heolfief/minimood/Hardware/PCB/main_board/3dmodels/RK09L12-L15H.STEP

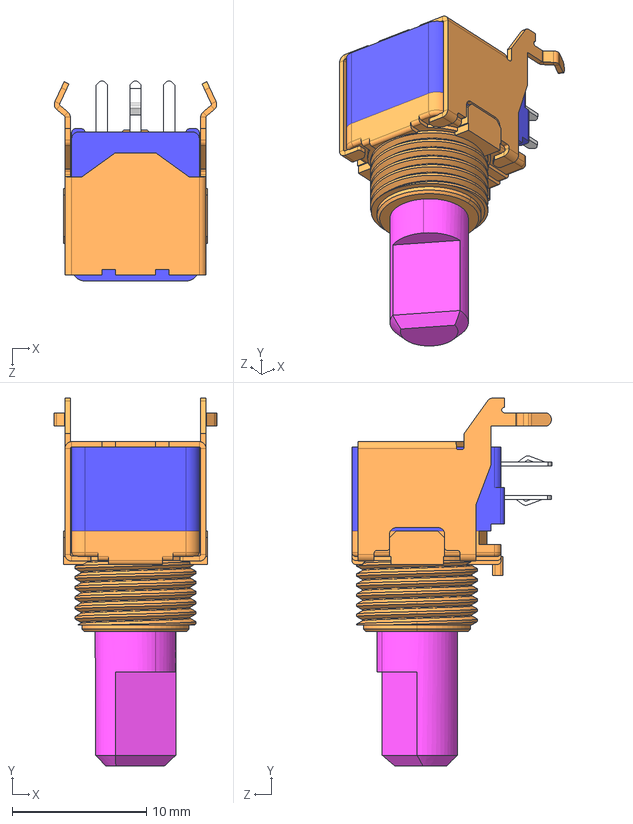
[picture p1: CAD file, 2020-09-23]
Hardware/PCB/main_board/3dmodels/RK09L12-L15H.STEP
12.1 x 27.4 x 14.9 mm
