heolfief/minimood/Hardware/PCB/main_board/3dmodels/096_oled_display.STEP

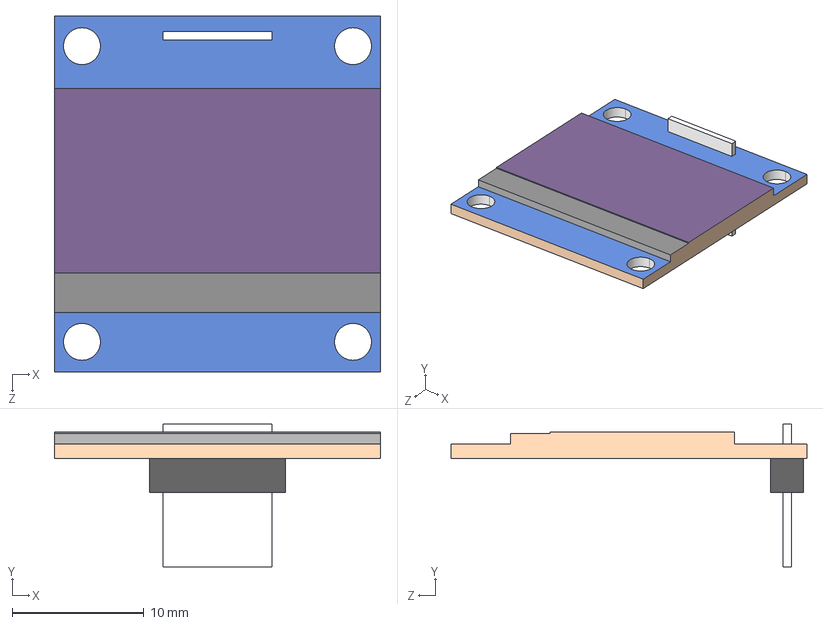
[picture p2: CAD file, 2020-03-08]
Hardware/PCB/main_board/3dmodels/096_oled_display.STEP
24.8 x 10.8 x 27.0 mm
