heolfief/minimood/Hardware/PCB/main_board/3dmodels/USB_Type_A_Socket.step

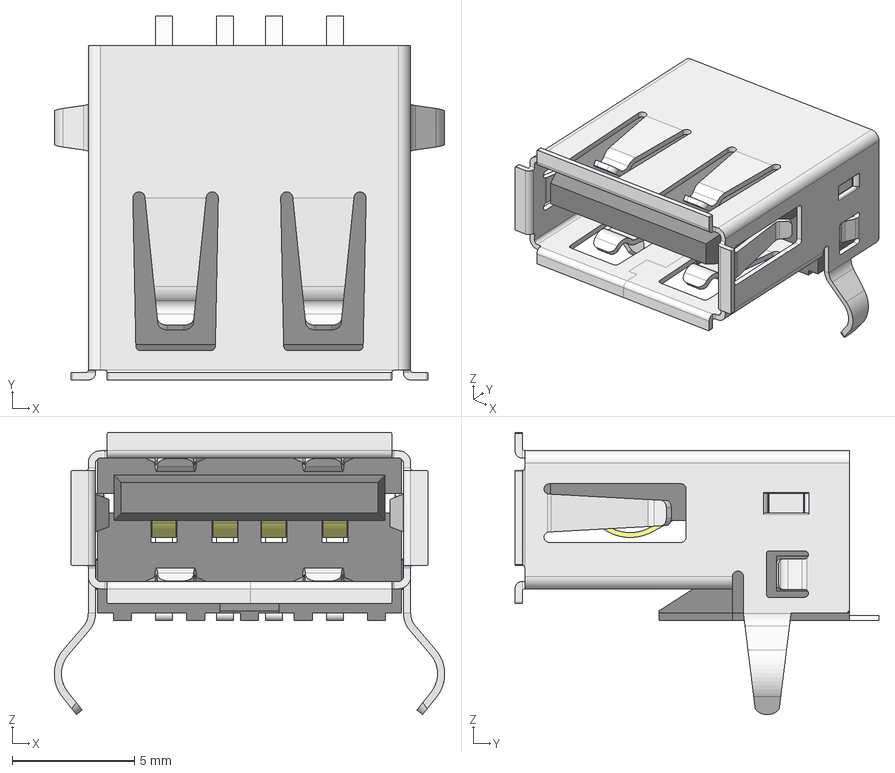
[picture p3: CAD file, 2020-02-25]
Hardware/PCB/main_board/3dmodels/USB_Type_A_Socket.step
16.0 x 14.9 x 11.5 mm
