heolfief/minimood/Hardware/PCB/main_board/3dmodels/USB 2.0 Type B Connector Right Angle (Würth 61400416121).stp

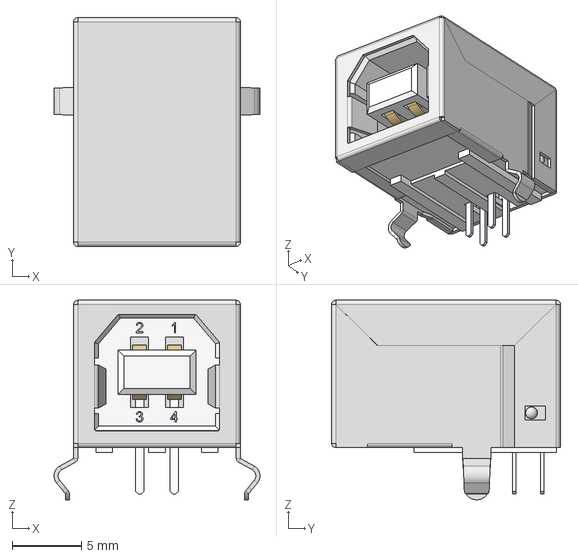
[picture p4: CAD file, 2020-02-25]
Hardware/PCB/main_board/3dmodels/USB 2.0 Type B Connector Right Angle (Würth 61400416121).stp
14.8 x 16.5 x 14.4 mm
