heolfief/minimood/Hardware/PCB/main_board/3dmodels/plastec_jack.stp

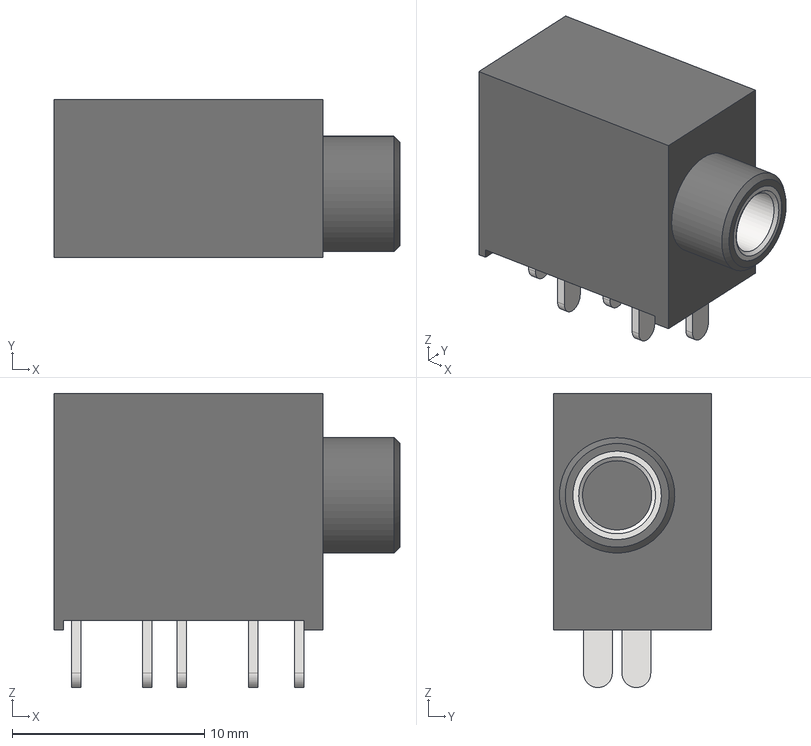
[picture p5: CAD file, 2020-02-25]
Hardware/PCB/main_board/3dmodels/plastec_jack.stp
18.0 x 8.20 x 15.3 mm
