heolfief/minimood/Hardware/Spice_sim_orcad/VCF_Orcad_simulation/VCF-PSpiceFiles/SCHEMATIC1/test/test.cir

** Profile: "SCHEMATIC1-test"  [ C:\Users\Julien\Documents\INSA EII\Semestre 8\ProjetPluri\minimood\Hardware\VCF_Orcad_simulation\vcf-pspicefiles\schematic1\test.sim ] 

** Creating circuit file "test.cir" 
** WARNING: THIS AUTOMATICALLY GENERATED FILE MAY BE OVERWRITTEN BY SUBSEQUENT SIMULATIONS

*Libraries: 
* Profile Libraries :
* Local Libraries :
* From [PSPICE NETLIST] section of C:\Users\Julien\AppData\Roaming\SPB_Data\cdssetup\OrCAD_PSpice\17.4.0\PSpice.ini file:
.lib "nom.lib" 

*Analysis directives: 
.TRAN  0 10m 0 1u 
.OPTIONS ADVCONV
.PROBE64 V(alias(*)) I(alias(*)) W(alias(*)) D(alias(*)) NOISE(alias(*)) 
.INC "..\SCHEMATIC1.net" 


.END
