heolfief/minimood/(list of files, drawings)

Other design files:
Hardware/Spice_sim_orcad/Distortion_Orcad_simulation/DISTORTION_ORCAD_SIMULATION.DSN
Hardware/Spice_sim_orcad/Distortion_Orcad_simulation/Distortion_Orcad_simulation.opj
Hardware/Spice_sim_orcad/VCF_Orcad_simulation/VCF.DSN
Hardware/Spice_sim_orcad/VCF_Orcad_simulation/VCF.opj
