heolfief/minimood/Hardware/PCB/main_board/main_board.kicad_pcb

## KiCad design Hardware/PCB/main_board/main_board.kicad_pcb (2020-09-23)

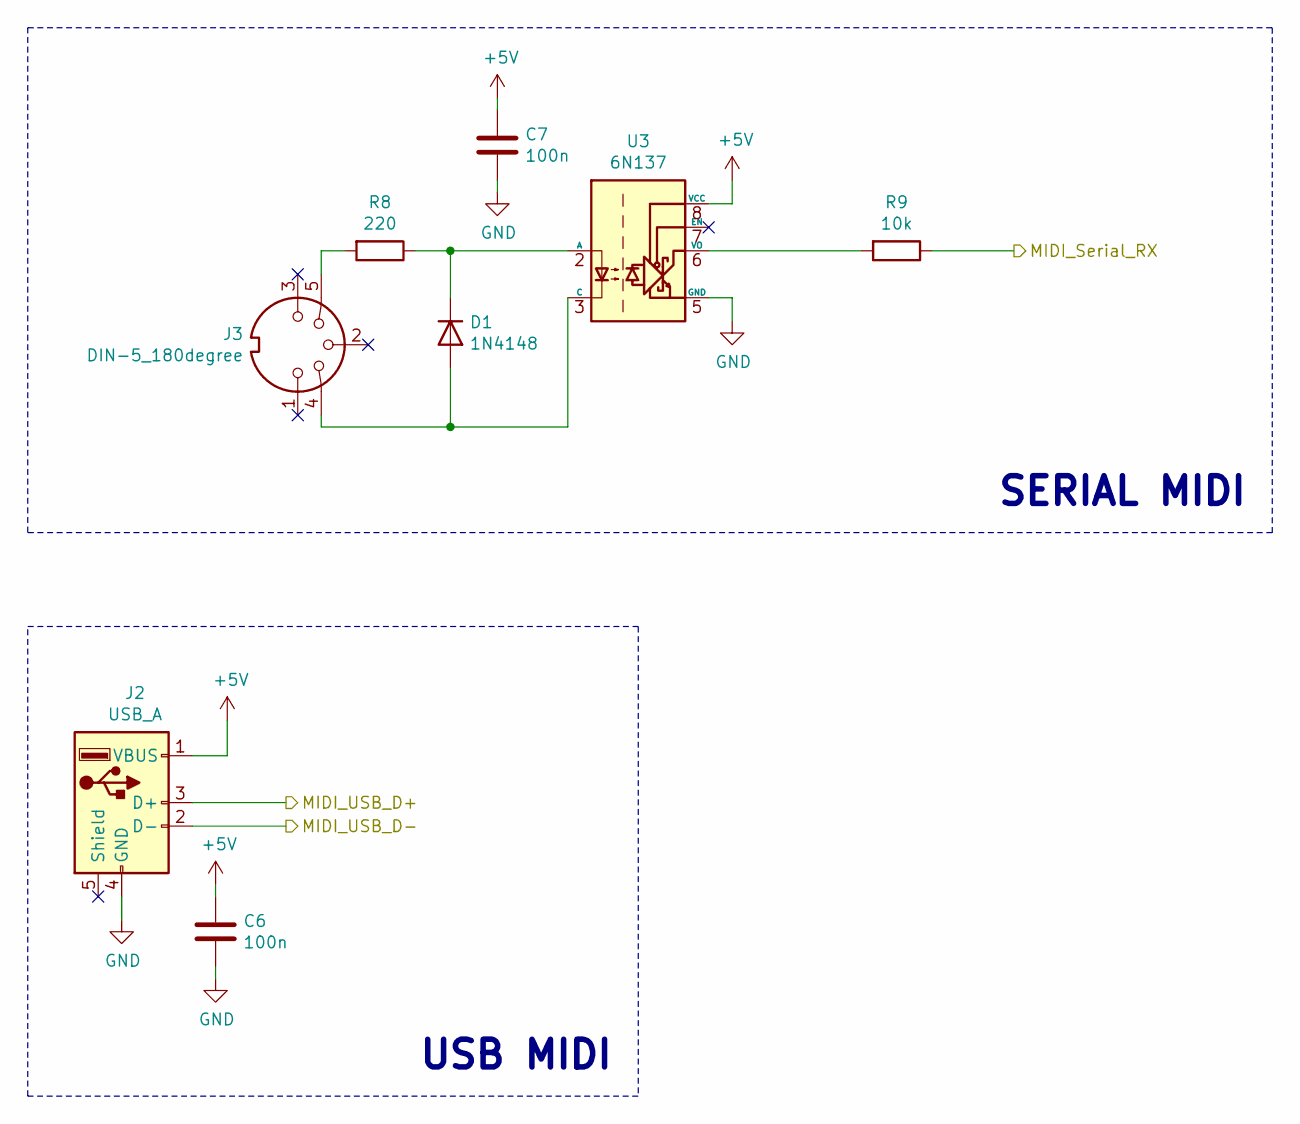
[picture p6: schematic MIDI.sch, MiniMood]

Parts:
C6, C7: 100n; C_0805_2012Metric
D1: 1N4148; D_SOD-123
J2: USB_A; USB_A_Stewart_SS-52100-001_Horizontal
J3: DIN-5_180degree; MIDI_DIN5
R8: 220; R_0805_2012Metric
R9: 10k; R_0805_2012Metric
U3: 6N137; SOIC-8_3.9x4.9mm_P1.27mm

Connections:
+5V: C6.1, C7.1, J2.1 (VBUS), U3.8 (VCC); also elsewhere on the board
/MIDI/MIDI_Serial_RX: R9.1; also elsewhere on the board
/MIDI/MIDI_USB_D+: J2.3 (D+); also elsewhere on the board
/MIDI/MIDI_USB_D-: J2.2 (D-); also elsewhere on the board
GND: C6.2, C7.2, J2.4 (GND), U3.5 (GND); also elsewhere on the board
unnamed: D1.1 (K), R8.1, U3.2 (A)
unnamed: D1.2 (A), J3.4, U3.3 (C)
unnamed: J3.5, R8.2
unnamed: R9.2, U3.6 (VO)

Notes on the sheet:
SERIAL MIDI
USB MIDI

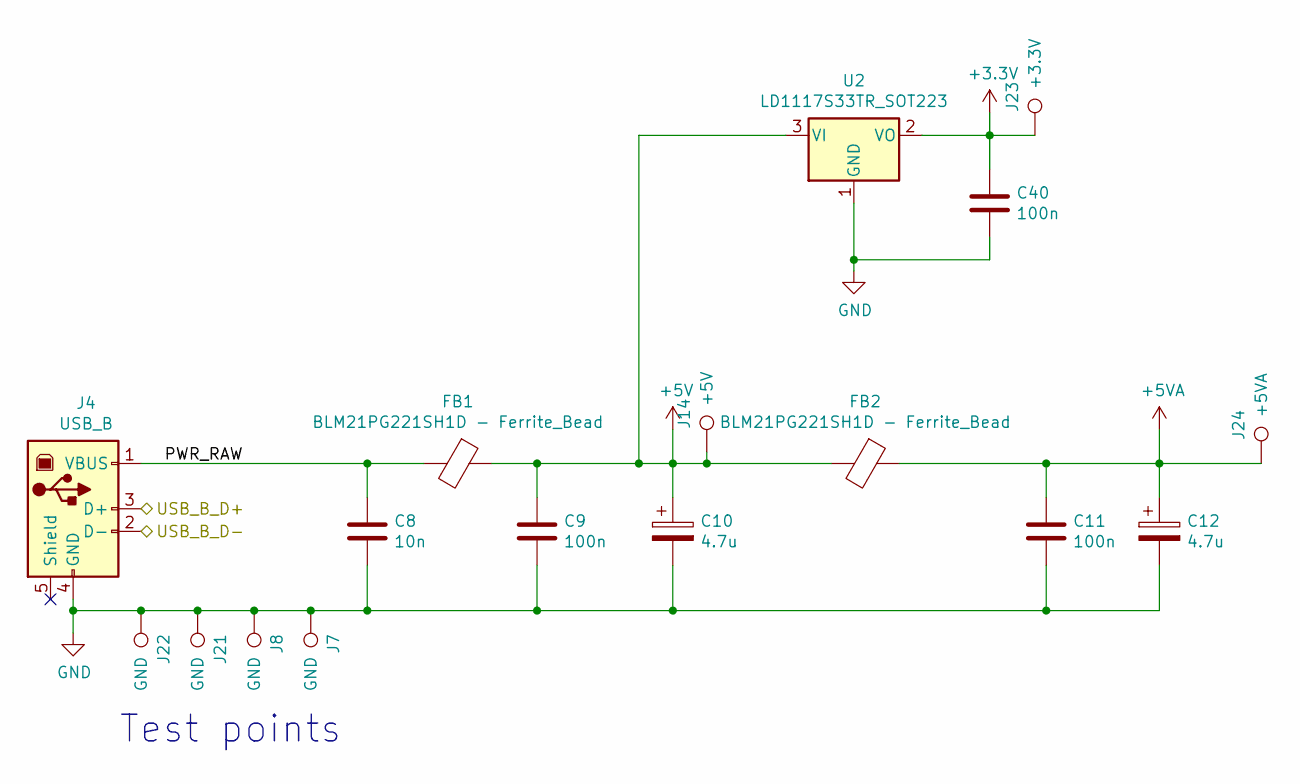
[picture p7: schematic power.sch, MiniMood]

Parts:
C8: 10n; C_0805_2012Metric
C9, C11, C40: 100n; C_0805_2012Metric
C10, C12: 4.7u; CP_Elec_4x5.4
FB1, FB2: BLM21PG221SH1D - Ferrite_Bead; L_0805_2012Metric
J4: USB_B; USB_B_OST_USB-B1HSxx_Horizontal
J7, J8, J21, J22: GND; TestPoint_THTPad_D1.0mm_Drill0.5mm
J14: +5V; TestPoint_THTPad_D1.0mm_Drill0.5mm
J23: +3.3V; TestPoint_THTPad_D1.0mm_Drill0.5mm
J24: +5VA; TestPoint_THTPad_D1.0mm_Drill0.5mm
U2: LD1117S33TR_SOT223; SOT-223-3_TabPin2

Connections:
+3V3: C40.1, J23.1, U2.2 (VO); also elsewhere on the board
+5V: C9.1, C10.1, FB1.1, FB2.2, J14.1, U2.3 (VI); also elsewhere on the board
+5VA: C11.1, C12.1, FB2.1, J24.1; also elsewhere on the board
/power/PWR_RAW: C8.1, FB1.2, J4.1 (VBUS)
/power/USB_B_D+: J4.3 (D+); also elsewhere on the board
/power/USB_B_D-: J4.2 (D-); also elsewhere on the board
GND: C8.2, C9.2, C10.2, C11.2, C12.2, C40.2, J4.4 (GND), J7.1, J8.1, J21.1, J22.1, U2.1 (GND); also elsewhere on the board

Notes on the sheet:
Test points

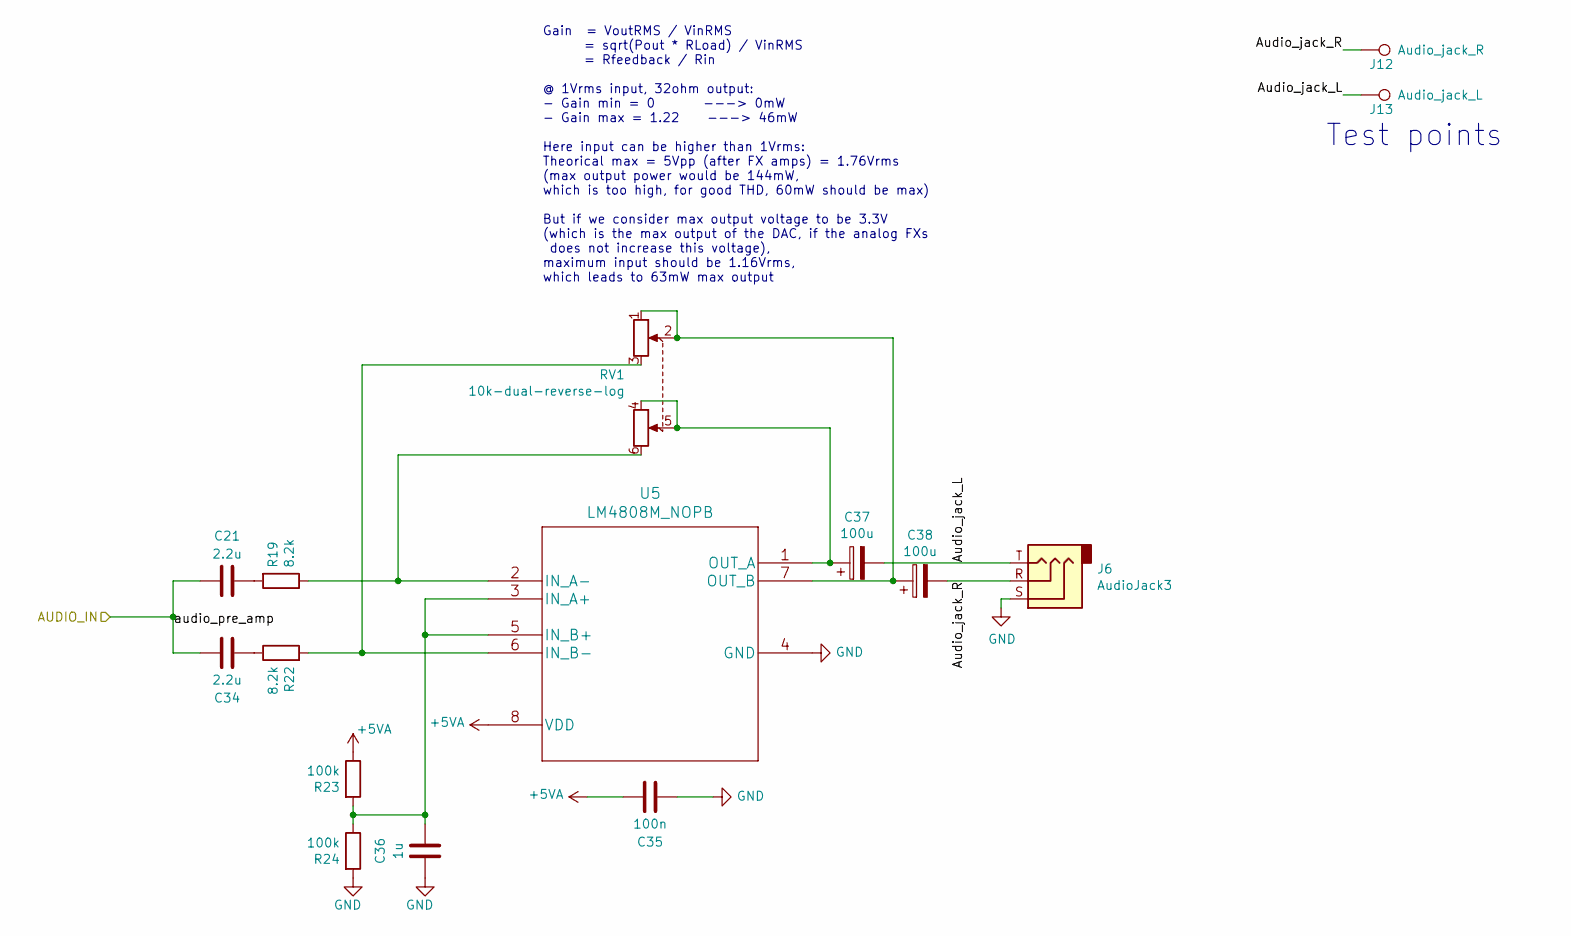
[picture p8: schematic audio_out.sch, MiniMood]

Parts:
C21, C34: 2.2u; C_0805_2012Metric
C35: 100n; C_0805_2012Metric
C36: 1u; C_0805_2012Metric
C37, C38: 100u; CP_Elec_6.3x5.4
J6: AudioJack3; audio_jack_3.5mm_KYCON_STX-3000
J12: Audio_jack_R; TestPoint_THTPad_D1.0mm_Drill0.5mm
J13: Audio_jack_L; TestPoint_THTPad_D1.0mm_Drill0.5mm
R19, R22: 8.2k; R_0805_2012Metric
R23, R24: 100k; R_0805_2012Metric
RV1: 10k-dual-reverse-log; Potentiometer_Alps_RK09L_Double_Horizontal
U5: LM4808M_NOPB; LM4808M&slash_NOPB

Connections:
+5VA: C35.2, R23.1, U5.8 (VDD); also elsewhere on the board
/audio_out/AUDIO_IN: C21.1, C34.2; also elsewhere on the board
/audio_out/Audio_jack_L: C37.2, J6.T, J13.1
/audio_out/Audio_jack_R: C38.2, J6.R, J12.1
GND: C35.1, C36.1, J6.S, R24.2, U5.4 (GND); also elsewhere on the board
unnamed: C21.2, R19.2
unnamed: C34.1, R22.1
unnamed: C36.2, R23.2, R24.1, U5.3 (IN_A+), U5.5 (IN_B+)
unnamed: C37.1, RV1.4, RV1.5, U5.1 (OUT_A)
unnamed: C38.1, RV1.1, RV1.2, U5.7 (OUT_B)
unnamed: R19.1, RV1.6, U5.2 (IN_A-)
unnamed: R22.2, RV1.3, U5.6 (IN_B-)

Notes on the sheet:
Test points
Gain = VoutRMS / VinRMS = sqrt(Pout * RLoad) / VinRMS = Rfeedback / Rin @ 1Vrms input, 32ohm output: - Gain min = 0 ---> 0mW - Gain max = 1.22 ---> 46mW Here input can be higher than 1Vrms: Theorical max = 5Vpp (after FX amps) = 1.76Vrms (max output power would be 144mW, which is too high, for good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

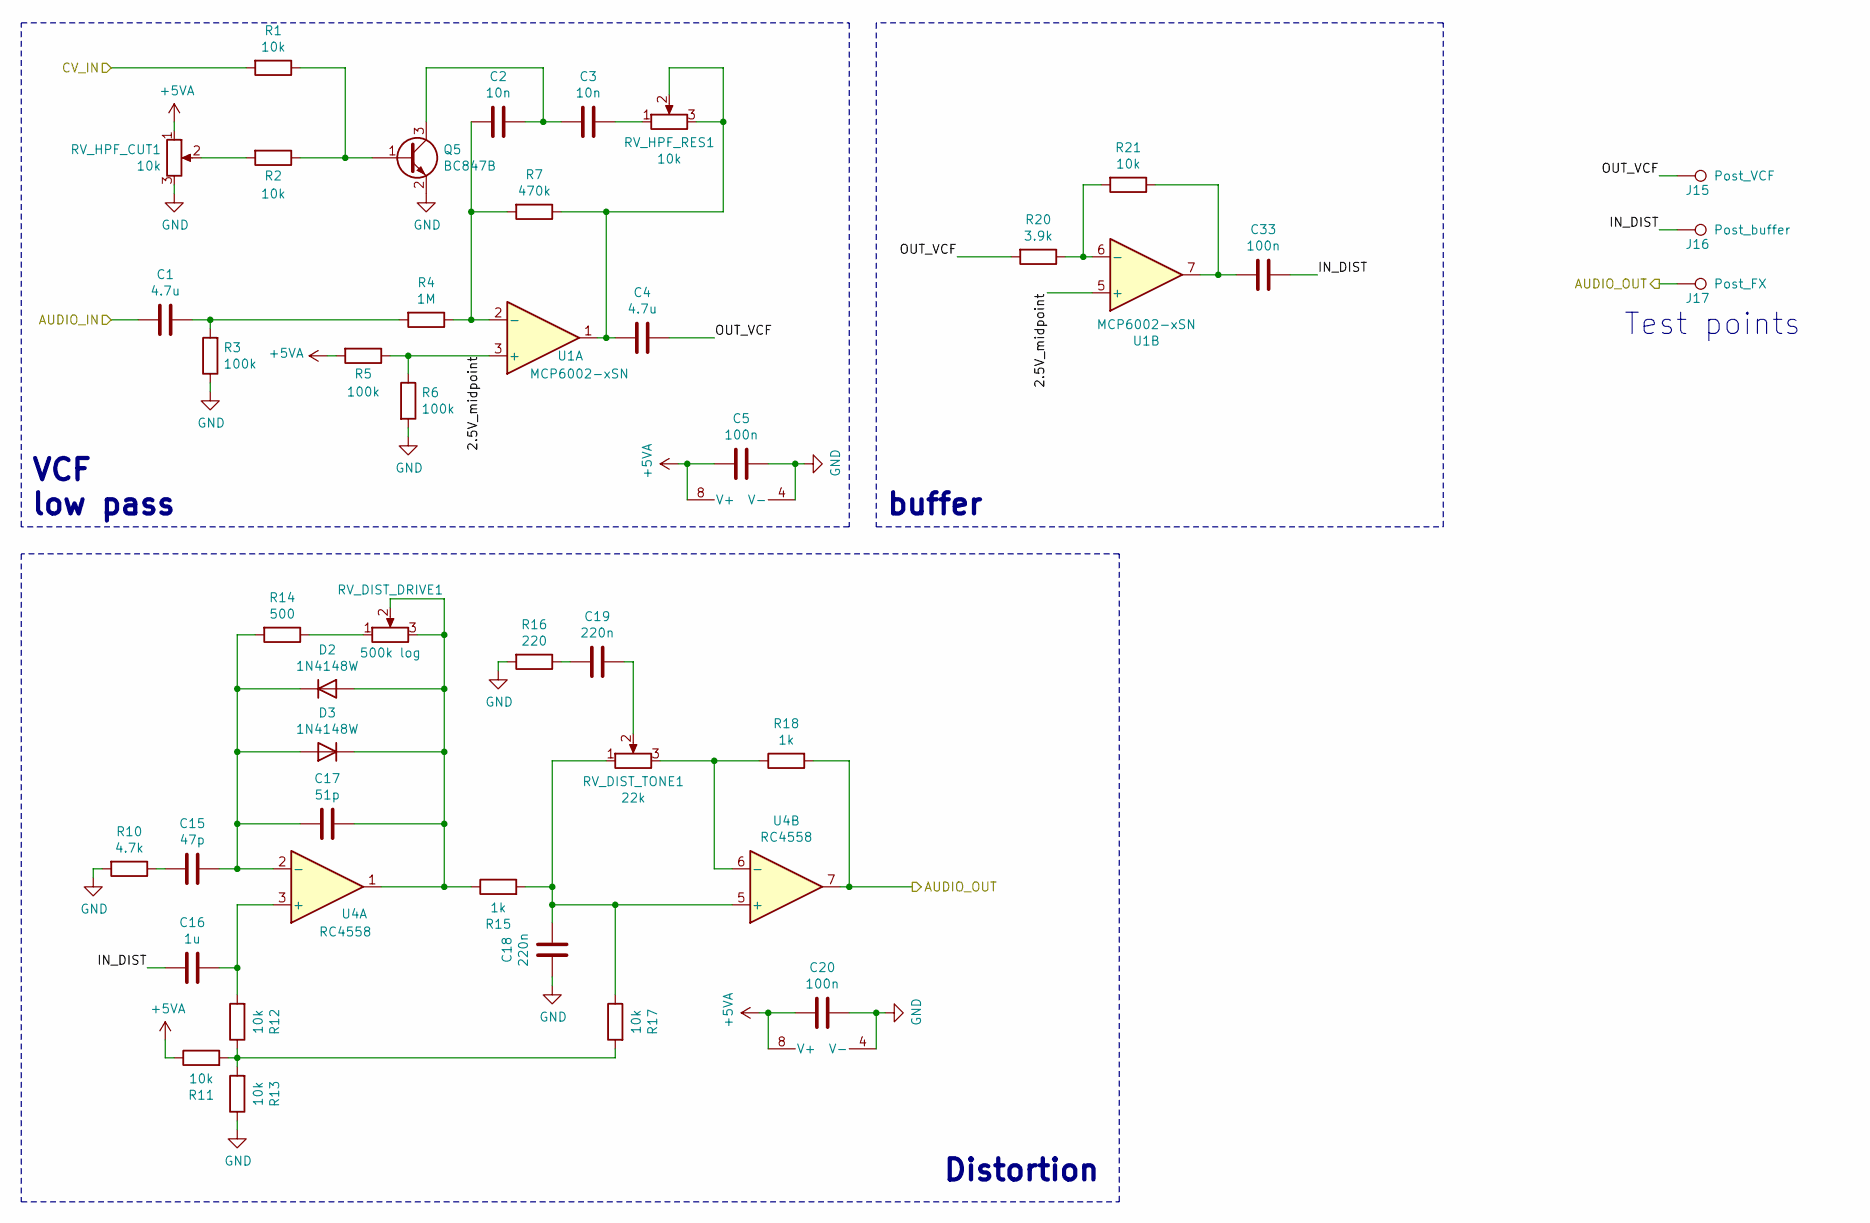
[picture p9: schematic analogFX.sch, MiniMood]

Parts:
C1, C4: 4.7u; C_0805_2012Metric
C2, C3: 10n; C_0805_2012Metric
C5, C20, C33: 100n; C_0805_2012Metric
C15: 47p; C_0805_2012Metric
C16: 1u; C_0805_2012Metric
C17: 51p; C_0805_2012Metric
C18, C19: 220n; C_0805_2012Metric
D2, D3: 1N4148W; D_SOD-123
J15: Post_VCF; TestPoint_THTPad_D1.0mm_Drill0.5mm
J16: Post_buffer; TestPoint_THTPad_D1.0mm_Drill0.5mm
J17: Post_FX; TestPoint_THTPad_D1.0mm_Drill0.5mm
Q5: BC847B; SOT-23
R1, R2, R11, R12, R13, R17, R21: 10k; R_0805_2012Metric
R3, R5, R6: 100k; R_0805_2012Metric
R4: 1M; R_0805_2012Metric
R7: 470k; R_0805_2012Metric
R10: 4.7k; R_0805_2012Metric
R14: 500; R_0805_2012Metric
R15, R18: 1k; R_0805_2012Metric
R16: 220; R_0805_2012Metric
R20: 3.9k; R_0805_2012Metric
RV_DIST_DRIVE1: 500k log; Potentiometer_Alps_RK09K_Single_Vertical
RV_DIST_TONE1: 22k; Potentiometer_Alps_RK09K_Single_Vertical
RV_HPF_CUT1: 10k; Potentiometer_Alps_RK09K_Single_Vertical
RV_HPF_RES1: 10k; Potentiometer_Alps_RK09K_Single_Vertical
U1: MCP6002-xSN; SOIC-8_3.9x4.9mm_P1.27mm
U4: RC4558; SOIC-8_3.9x4.9mm_P1.27mm

Connections:
+5VA: C5.2, C20.2, R5.2, R11.1, RV_HPF_CUT1.1, U1.8 (V+), U4.8 (V+); also elsewhere on the board
/analogFX/2.5V_midpoint: R5.1, R6.1, U1.3 (+), U1.5 (+)
/analogFX/AUDIO_IN: C1.2; also elsewhere on the board
/analogFX/CV_IN: R1.2; also elsewhere on the board
/analogFX/IN_DIST: C16.2, C33.1, J16.1
/analogFX/OUT_VCF: C4.1, J15.1, R20.2
/audio_out/AUDIO_IN: J17.1, R18.2, U4.7; also elsewhere on the board
GND: C5.1, C18.2, C20.1, Q5.2 (E), R3.1, R6.2, R10.2, R13.1, R16.2, RV_HPF_CUT1.3, U1.4 (V-), U4.4 (V-); also elsewhere on the board
unnamed: C1.1, R3.2, R4.2
unnamed: C2.1, C3.2, Q5.3 (C)
unnamed: C2.2, R4.1, R7.2, U1.2 (-)
unnamed: C3.1, RV_HPF_RES1.1
unnamed: C4.2, R7.1, RV_HPF_RES1.2, RV_HPF_RES1.3, U1.1
unnamed: C15.1, C17.2, D2.1 (K), D3.2 (A), R14.2, U4.2 (-)
unnamed: C15.2, R10.1
unnamed: C16.1, R12.2, U4.3 (+)
unnamed: C17.1, D2.2 (A), D3.1 (K), R15.1, RV_DIST_DRIVE1.2, RV_DIST_DRIVE1.3, U4.1
unnamed: C18.1, R15.2, R17.1, RV_DIST_TONE1.1, U4.5 (+)
unnamed: C19.1, RV_DIST_TONE1.2
unnamed: C19.2, R16.1
unnamed: C33.2, R21.1, U1.7
unnamed: Q5.1 (B), R1.1, R2.1
unnamed: R2.2, RV_HPF_CUT1.2
unnamed: R11.2, R12.1, R13.2, R17.2
unnamed: R14.1, RV_DIST_DRIVE1.1
unnamed: R18.1, RV_DIST_TONE1.3, U4.6 (-)
unnamed: R20.1, R21.2, U1.6 (-)

Notes on the sheet:
VCF low pass
Distortion
buffer
Test points

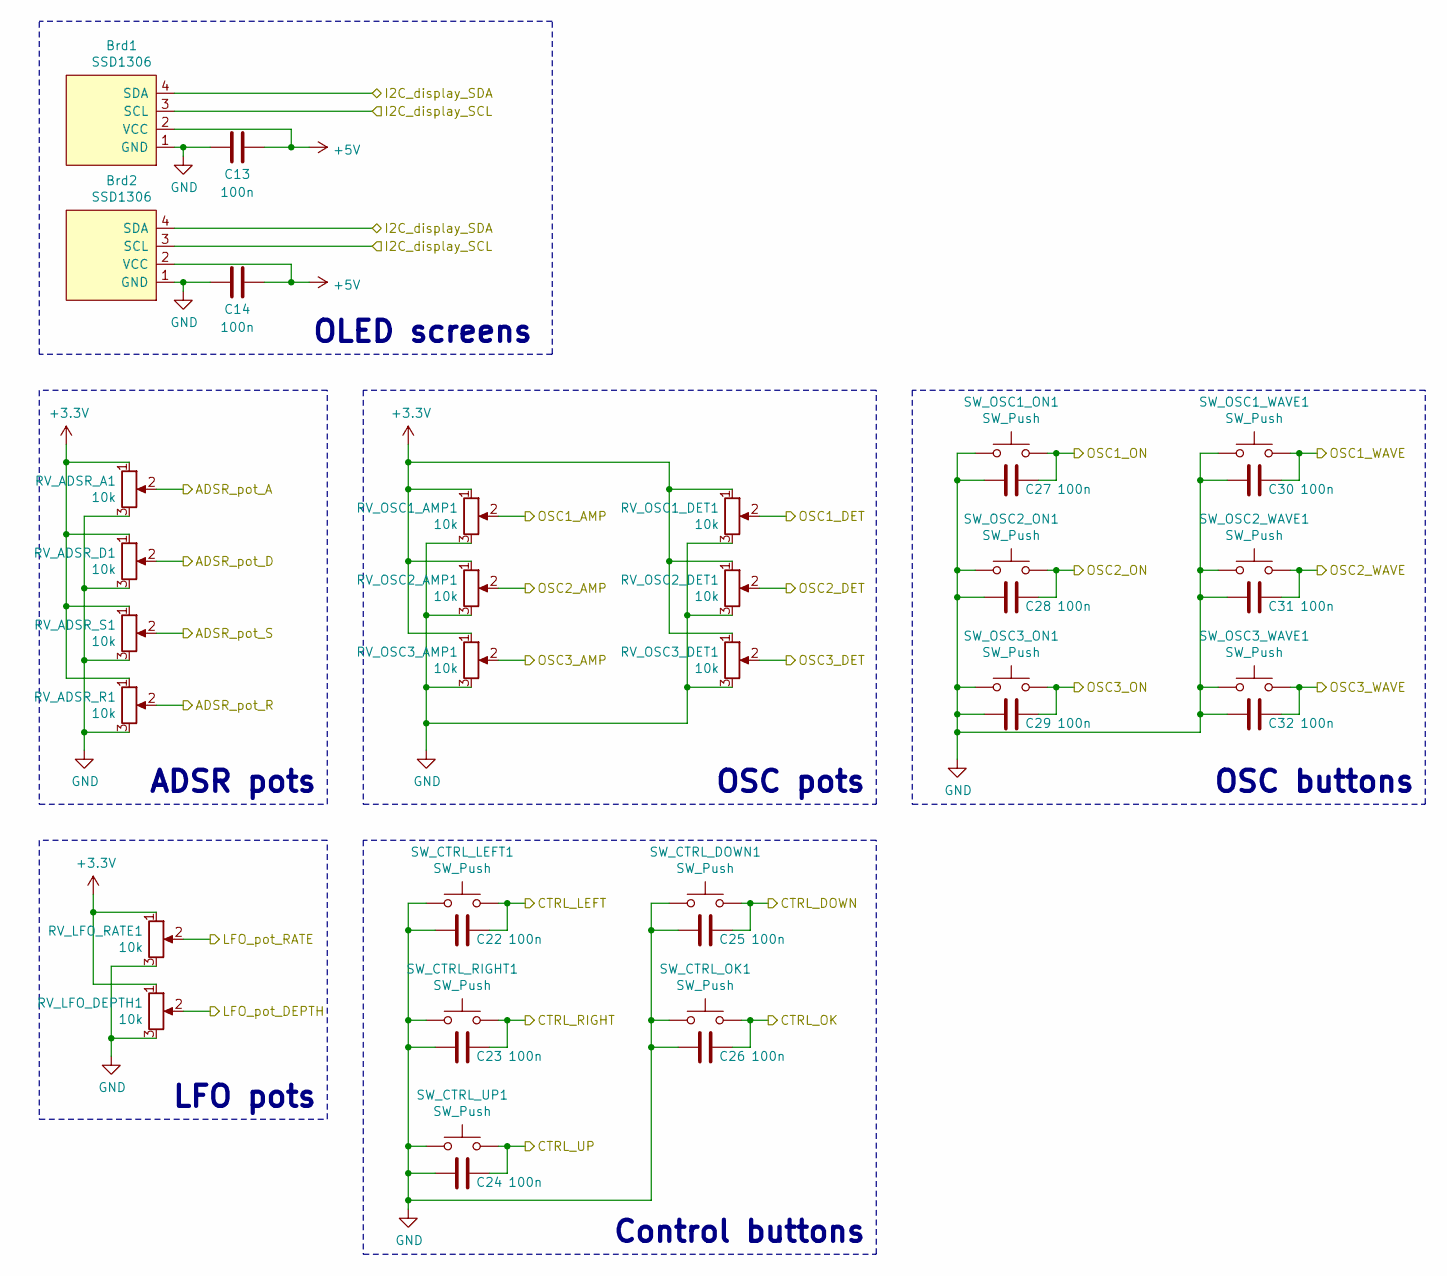
[picture p10: schematic HMI.sch, MiniMood]

Parts:
Brd1, Brd2: SSD1306; 128x64OLED
C13, C14, C22, C23, C24, C25, C26, C27, C28, C29, C30, C31, C32: 100n; C_0805_2012Metric
RV_ADSR_A1: 10k; Potentiometer_Alps_RK09K_Single_Vertical
RV_ADSR_D1: 10k; Potentiometer_Alps_RK09K_Single_Vertical
RV_ADSR_R1: 10k; Potentiometer_Alps_RK09K_Single_Vertical
RV_ADSR_S1: 10k; Potentiometer_Alps_RK09K_Single_Vertical
RV_LFO_DEPTH1: 10k; Potentiometer_Alps_RK09K_Single_Vertical
RV_LFO_RATE1: 10k; Potentiometer_Alps_RK09K_Single_Vertical
RV_OSC1_AMP1, RV_OSC1_DET1, RV_OSC2_AMP1, RV_OSC2_DET1, RV_OSC3_AMP1, RV_OSC3_DET1: 10k; Potentiometer_Alps_RK09K_Single_Vertical
SW_CTRL_DOWN1: SW_Push; SW_PUSH_6mm_H13mm
SW_CTRL_LEFT1: SW_Push; SW_PUSH_6mm_H13mm
SW_CTRL_OK1: SW_Push; SW_PUSH_6mm_H13mm
SW_CTRL_RIGHT1: SW_Push; SW_PUSH_6mm_H13mm
SW_CTRL_UP1: SW_Push; SW_PUSH_6mm_H13mm
SW_OSC1_ON1, SW_OSC1_WAVE1, SW_OSC2_ON1, SW_OSC2_WAVE1, SW_OSC3_ON1, SW_OSC3_WAVE1: SW_Push; SW_PUSH_6mm_H13mm

Connections:
+3V3: RV_ADSR_A1.1, RV_ADSR_D1.1, RV_ADSR_R1.1, RV_ADSR_S1.1, RV_LFO_DEPTH1.1, RV_LFO_RATE1.1, RV_OSC1_AMP1.1, RV_OSC1_DET1.1, RV_OSC2_AMP1.1, RV_OSC2_DET1.1, RV_OSC3_AMP1.1, RV_OSC3_DET1.1; also elsewhere on the board
+5V: Brd1.2 (VCC), Brd2.2 (VCC), C13.1, C14.1; also elsewhere on the board
/HMI/CTRL_DOWN: C25.1, SW_CTRL_DOWN1.2; also elsewhere on the board
/HMI/CTRL_LEFT: C22.1, SW_CTRL_LEFT1.2; also elsewhere on the board
/HMI/CTRL_OK: C26.1, SW_CTRL_OK1.2; also elsewhere on the board
/HMI/CTRL_RIGHT: C23.1, SW_CTRL_RIGHT1.2; also elsewhere on the board
/HMI/CTRL_UP: C24.1, SW_CTRL_UP1.2; also elsewhere on the board
/HMI/I2C_display_SCL: Brd1.3 (SCL), Brd2.3 (SCL); also elsewhere on the board
/HMI/I2C_display_SDA: Brd1.4 (SDA), Brd2.4 (SDA); also elsewhere on the board
/MCU/ADC1_IN2: RV_OSC1_AMP1.2; also elsewhere on the board
/MCU/ADC1_IN3: RV_OSC2_AMP1.2; also elsewhere on the board
/MCU/ADC1_IN6: RV_LFO_RATE1.2; also elsewhere on the board
/MCU/ADC1_IN7: RV_OSC3_DET1.2; also elsewhere on the board
/MCU/ADC1_IN8: RV_OSC3_AMP1.2; also elsewhere on the board
/MCU/ADC1_IN9: RV_OSC2_DET1.2; also elsewhere on the board
/MCU/ADC1_IN10: RV_ADSR_D1.2; also elsewhere on the board
/MCU/ADC1_IN11: RV_ADSR_A1.2; also elsewhere on the board
/MCU/ADC1_IN12: RV_ADSR_R1.2; also elsewhere on the board
/MCU/ADC1_IN13: RV_ADSR_S1.2; also elsewhere on the board
/MCU/ADC1_IN14: RV_OSC1_DET1.2; also elsewhere on the board
/MCU/ADC1_IN15: RV_LFO_DEPTH1.2; also elsewhere on the board
/MCU/GPIO_PB4: C27.1, SW_OSC1_ON1.2; also elsewhere on the board
/MCU/GPIO_PB5: C31.1, SW_OSC2_WAVE1.2; also elsewhere on the board
/MCU/GPIO_PB8: C30.1, SW_OSC1_WAVE1.2; also elsewhere on the board
/MCU/GPIO_PB9: C28.1, SW_OSC2_ON1.2; also elsewhere on the board
/MCU/GPIO_PB10: C29.1, SW_OSC3_ON1.2; also elsewhere on the board
/MCU/GPIO_PB13: C32.1, SW_OSC3_WAVE1.2; also elsewhere on the board
GND: Brd1.1 (GND), Brd2.1 (GND), C13.2, C14.2, C22.2, C23.2, C24.2, C25.2, C26.2, C27.2, C28.2, C29.2, C30.2, C31.2, C32.2, RV_ADSR_A1.3, RV_ADSR_D1.3, RV_ADSR_R1.3, RV_ADSR_S1.3, RV_LFO_DEPTH1.3, RV_LFO_RATE1.3, RV_OSC1_AMP1.3, RV_OSC1_DET1.3, RV_OSC2_AMP1.3, RV_OSC2_DET1.3, RV_OSC3_AMP1.3, RV_OSC3_DET1.3, SW_CTRL_DOWN1.1, SW_CTRL_LEFT1.1, SW_CTRL_OK1.1, SW_CTRL_RIGHT1.1, SW_CTRL_UP1.1, SW_OSC1_ON1.1, SW_OSC1_WAVE1.1, SW_OSC2_ON1.1, SW_OSC2_WAVE1.1, SW_OSC3_ON1.1, SW_OSC3_WAVE1.1; also elsewhere on the board

Notes on the sheet:
OLED screens
ADSR pots
LFO pots
OSC pots
OSC buttons
Control buttons

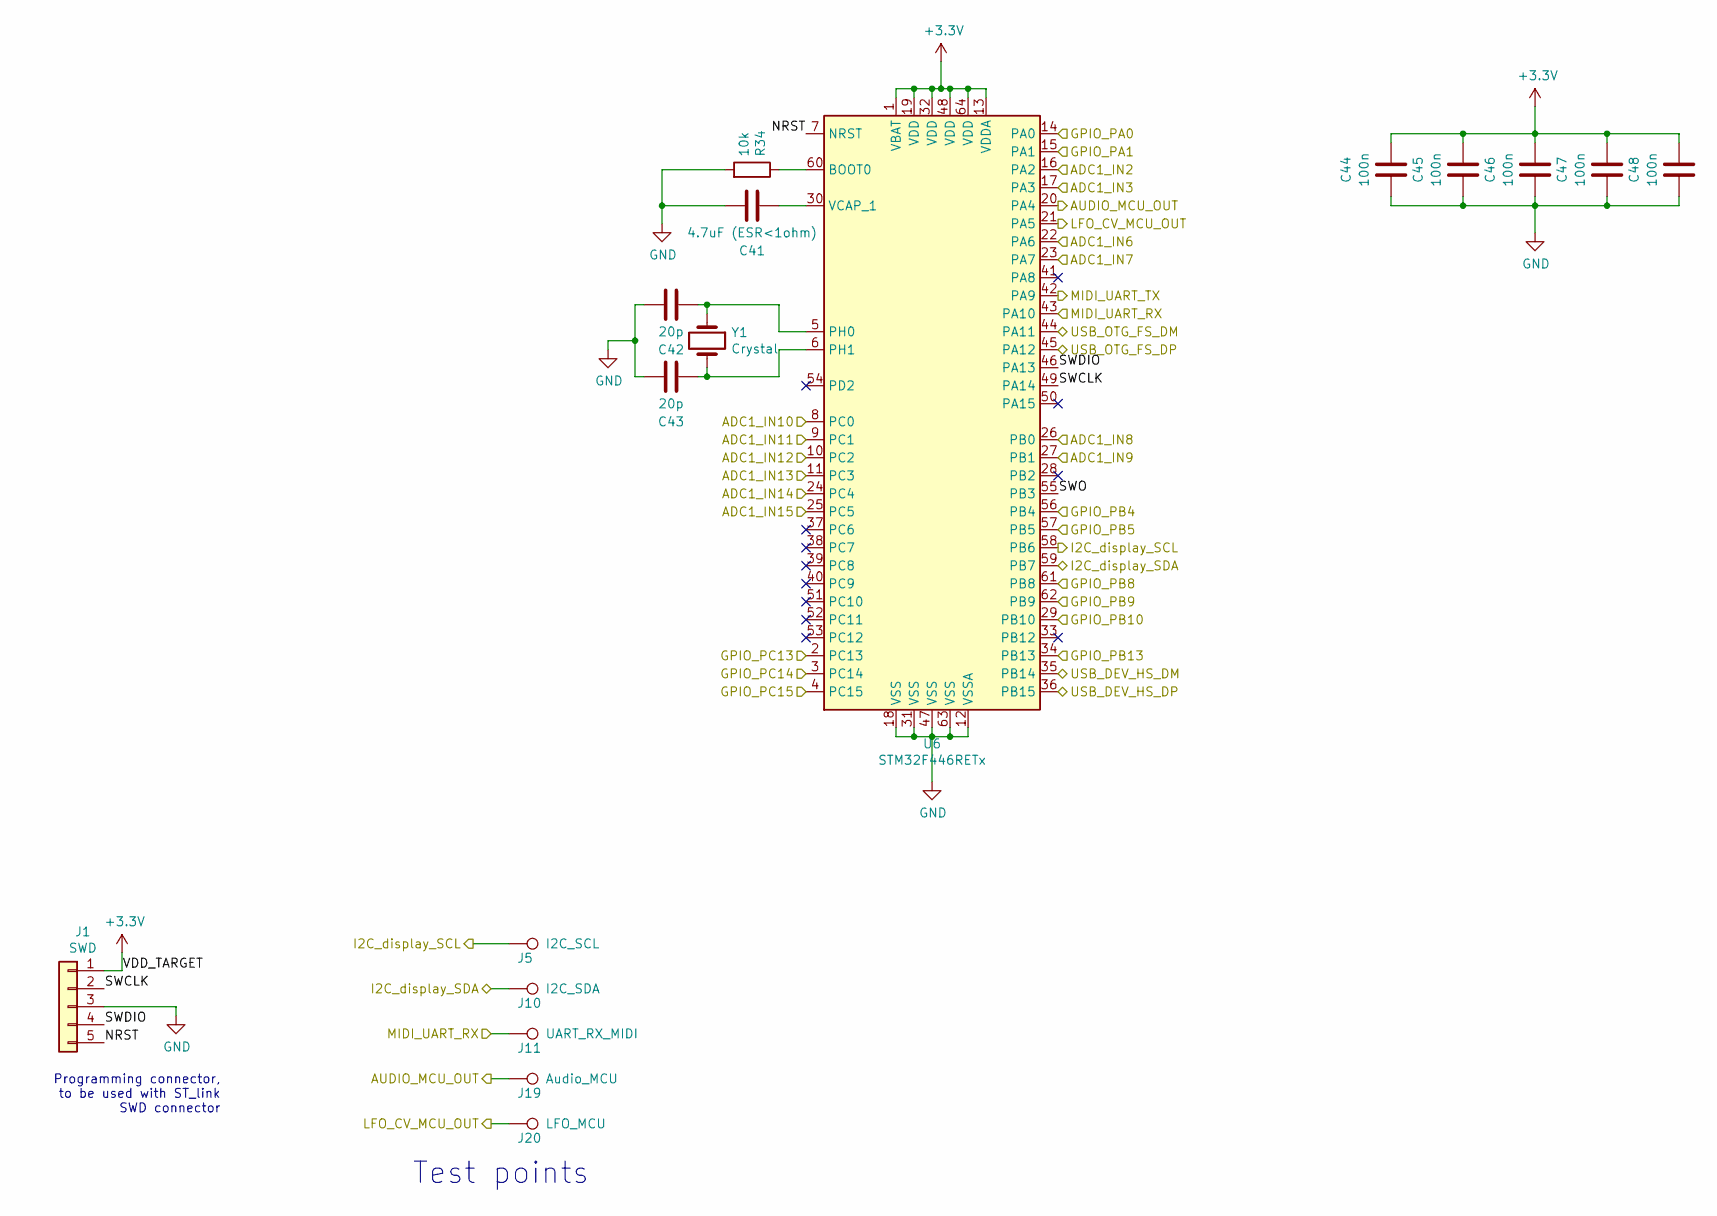
[picture p11: schematic MCU.sch, MiniMood]

Parts:
C41: 4.7uF (ESR<1ohm); C_0805_2012Metric
C42, C43: 20p; C_0805_2012Metric
C44, C45, C46, C47, C48: 100n; C_0805_2012Metric
J1: SWD; PinHeader_1x05_P2.54mm_Vertical
J5: I2C_SCL; TestPoint_THTPad_D1.0mm_Drill0.5mm
J10: I2C_SDA; TestPoint_THTPad_D1.0mm_Drill0.5mm
J11: UART_RX_MIDI; TestPoint_THTPad_D1.0mm_Drill0.5mm
J19: Audio_MCU; TestPoint_THTPad_D1.0mm_Drill0.5mm
J20: LFO_MCU; TestPoint_THTPad_D1.0mm_Drill0.5mm
R34: 10k; R_0805_2012Metric
U6: STM32F446RETx; LQFP-64_10x10mm_P0.5mm
Y1: Crystal; Crystal_SMD_3225-4Pin_3.2x2.5mm_HandSoldering

Connections:
+3V3: C44.1, C45.1, C46.1, C47.1, C48.1, J1.1, U6.1 (VBAT), U6.13 (VDDA), U6.19 (VDD), U6.32 (VDD), U6.48 (VDD), U6.64 (VDD); also elsewhere on the board
/HMI/CTRL_DOWN: U6.2 (PC13); also elsewhere on the board
/HMI/CTRL_LEFT: U6.14 (PA0); also elsewhere on the board
/HMI/CTRL_OK: U6.4 (PC15); also elsewhere on the board
/HMI/CTRL_RIGHT: U6.3 (PC14); also elsewhere on the board
/HMI/CTRL_UP: U6.15 (PA1); also elsewhere on the board
/HMI/I2C_display_SCL: J5.1, U6.58 (PB6); also elsewhere on the board
/HMI/I2C_display_SDA: J10.1, U6.59 (PB7); also elsewhere on the board
/MCU/ADC1_IN2: U6.16 (PA2); also elsewhere on the board
/MCU/ADC1_IN3: U6.17 (PA3); also elsewhere on the board
/MCU/ADC1_IN6: U6.22 (PA6); also elsewhere on the board
/MCU/ADC1_IN7: U6.23 (PA7); also elsewhere on the board
/MCU/ADC1_IN8: U6.26 (PB0); also elsewhere on the board
/MCU/ADC1_IN9: U6.27 (PB1); also elsewhere on the board
/MCU/ADC1_IN10: U6.8 (PC0); also elsewhere on the board
/MCU/ADC1_IN11: U6.9 (PC1); also elsewhere on the board
/MCU/ADC1_IN12: U6.10 (PC2); also elsewhere on the board
/MCU/ADC1_IN13: U6.11 (PC3); also elsewhere on the board
/MCU/ADC1_IN14: U6.24 (PC4); also elsewhere on the board
/MCU/ADC1_IN15: U6.25 (PC5); also elsewhere on the board
/MCU/GPIO_PB4: U6.56 (PB4); also elsewhere on the board
/MCU/GPIO_PB5: U6.57 (PB5); also elsewhere on the board
/MCU/GPIO_PB8: U6.61 (PB8); also elsewhere on the board
/MCU/GPIO_PB9: U6.62 (PB9); also elsewhere on the board
/MCU/GPIO_PB10: U6.29 (PB10); also elsewhere on the board
/MCU/GPIO_PB13: U6.34 (PB13); also elsewhere on the board
/MCU/MIDI_UART_TX: U6.42 (PA9)
/MCU/NRST: J1.5, U6.7 (NRST)
/MCU/SWCLK: J1.2, U6.49 (PA14)
/MCU/SWDIO: J1.4, U6.46 (PA13)
/MCU/SWO: U6.55 (PB3)
/MIDI/MIDI_Serial_RX: J11.1, U6.43 (PA10); also elsewhere on the board
/MIDI/MIDI_USB_D+: U6.45 (PA12); also elsewhere on the board
/MIDI/MIDI_USB_D-: U6.44 (PA11); also elsewhere on the board
/analogFX/AUDIO_IN: J19.1, U6.20 (PA4); also elsewhere on the board
/analogFX/CV_IN: J20.1, U6.21 (PA5); also elsewhere on the board
/power/USB_B_D+: U6.36 (PB15); also elsewhere on the board
/power/USB_B_D-: U6.35 (PB14); also elsewhere on the board
GND: C41.1, C42.1, C43.1, C44.2, C45.2, C46.2, C47.2, C48.2, J1.3, R34.2, U6.12 (VSSA), U6.18 (VSS), U6.31 (VSS), U6.47 (VSS), U6.63 (VSS); also elsewhere on the board
unnamed: C41.2, U6.30 (VCAP_1)
unnamed: C42.2, U6.5 (PH0), Y1.1
unnamed: C43.2, U6.6 (PH1), Y1.2
unnamed: R34.1, U6.60 (BOOT0)

Notes on the sheet:
Programming connector, to be used with ST_link SWD connector
Test points

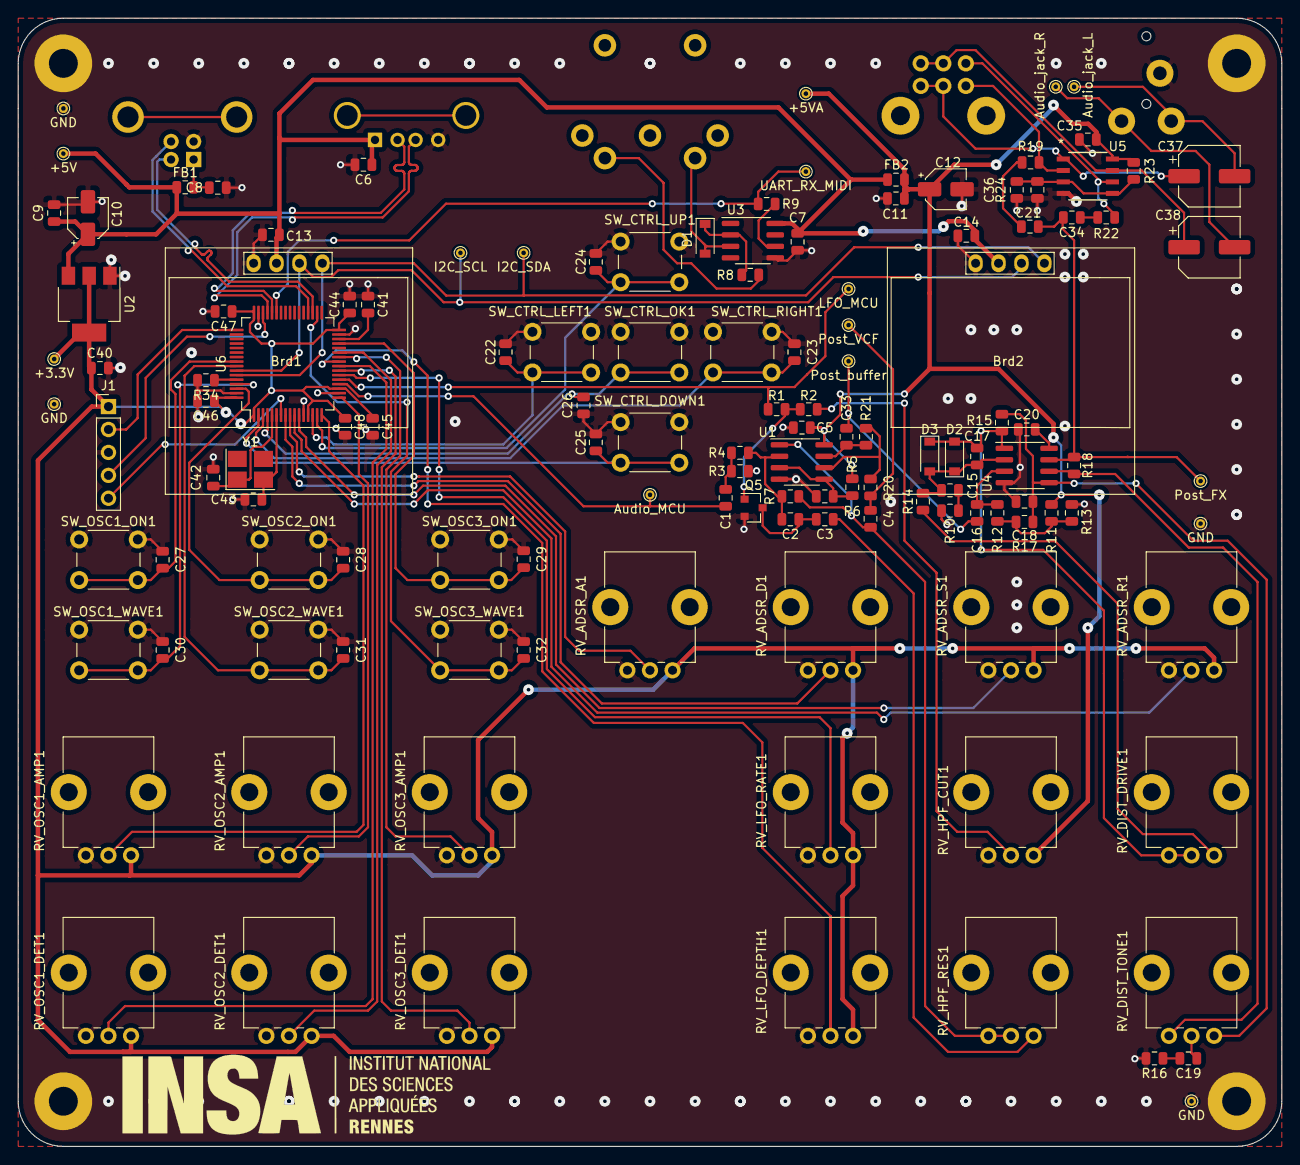
[picture p12: board main_board.kicad_pcb from above]

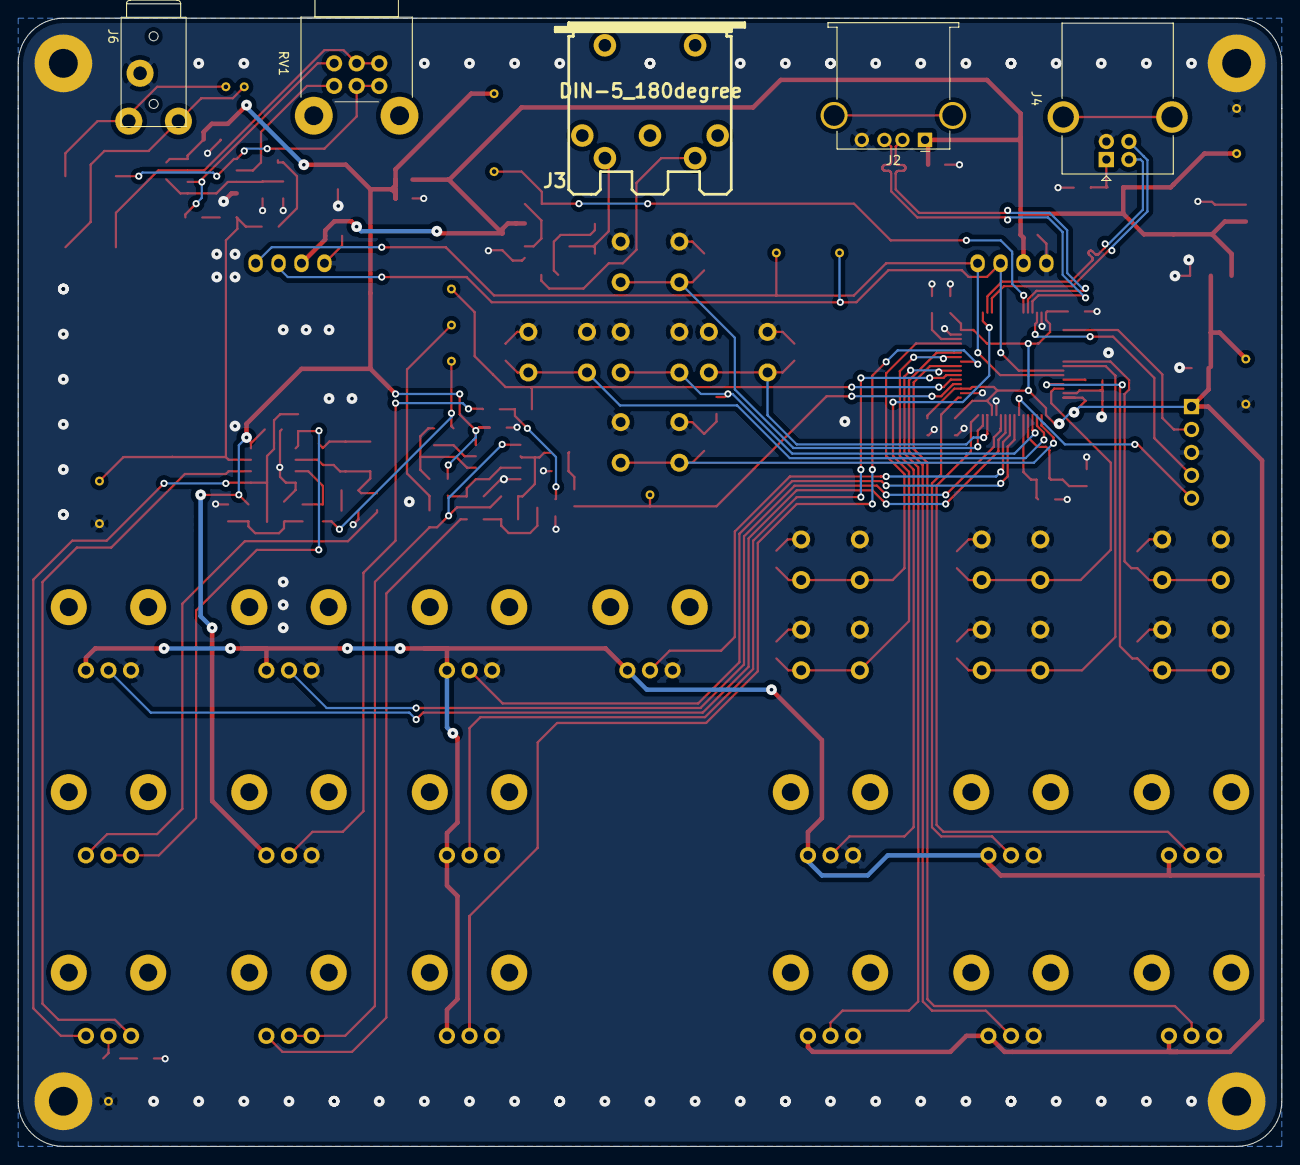
[picture p13: board main_board.kicad_pcb from below]

Board: 2 copper layers, 140.0 x 125.0 mm, 137 parts (5 on the bottom side), 80 nets.
