heolfief/minimood/Software/Firmware/Core/Src/main.c

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
/* Includes ------------------------------------------------------------------*/
#include "main.h"

/* USER CODE BEGIN Includes */
#include "audio_core/audio_core.h"
#include "HMI/HMI.h"
#include "HMI/display_core.h"
/* USER CODE END Includes */

ADC_HandleTypeDef hadc1;
DMA_HandleTypeDef hdma_adc1;

DAC_HandleTypeDef hdac;

I2C_HandleTypeDef hi2c1;

TIM_HandleTypeDef htim4;
TIM_HandleTypeDef htim6;
TIM_HandleTypeDef htim7;

/* USER CODE BEGIN PV */

Audio_core ac;
Hmi hmi;

/* USER CODE END PV */

void SystemClock_Config(void);
static void MX_GPIO_Init(void);
static void MX_DMA_Init(void);
static void MX_DAC_Init(void);
static void MX_TIM6_Init(void);
static void MX_ADC1_Init(void);
static void MX_I2C1_Init(void);
static void MX_TIM7_Init(void);
static void MX_TIM4_Init(void);
/**
  * @brief  The application entry point.
  * @retval int
  */
int main(void)
{
  /* MCU Configuration--------------------------------------------------------*/

  /* Reset of all peripherals, Initializes the Flash interface and the Systick. */
  HAL_Init();

  /* Configure the system clock */
  SystemClock_Config();

  /* Initialize all configured peripherals */
  MX_GPIO_Init();
  MX_DMA_Init();
  MX_DAC_Init();
  MX_TIM6_Init();
  MX_ADC1_Init();
  MX_I2C1_Init();
  MX_TIM7_Init();
  MX_TIM4_Init();
  /* USER CODE BEGIN 2 */

  HAL_TIM_Base_Start_IT(&htim6);		// Start TIM6 (Audio core timer), IT mode

  HAL_DAC_Start(&hdac,DAC_CHANNEL_1);	// Start DAC on channel 1
  HAL_DAC_Start(&hdac,DAC_CHANNEL_2);	// Start DAC on channel 2

  HAL_ADC_Start_DMA(&hadc1, (uint32_t*)hmi.adc_raw_data, NBR_OF_POTS);	// Start HMI potentiometers ADC

  hmi_init(&hmi);
  HAL_TIM_Base_Start_IT(&htim7);		// Start TIM7 (HMI inputs timer), IT mode
  HAL_TIM_Base_Start_IT(&htim4);		// Start TIM4 (HMI display refresh timer), IT mode

  synth_core_start(&ac);


  // The following code is for test purpose ////////////////

  ac.sys_param.env.attack = 0.5;
  ac.sys_param.env.decay = 0;
  ac.sys_param.env.sustain = 1;
  ac.sys_param.env.release = 0.5;

  ac.sys_param.osc1.onoff = ON;
  ac.sys_param.osc2.onoff = ON;
  ac.sys_param.osc3.onoff = ON;

  ac.sys_param.osc1.wave = SIN;
  ac.sys_param.osc2.wave = SQR;
  ac.sys_param.osc3.wave = TRI;
  ac.sys_param.osc1.amp = 1;
  ac.sys_param.osc2.amp = 1;
  ac.sys_param.osc3.amp = 1;

  ac.sys_param.osc1.detune = 0;
  ac.sys_param.osc2.detune = 0;
  ac.sys_param.osc3.detune = 0;

  ac.sys_param.lfo.amp = 0.5;
  ac.sys_param.lfo.wave = SIN;
  ac.sys_param.lfo.freq = 51; // ranges from 0 to 1023, corresponding to 0 to 20Hz
  ac.sys_param.lfo.onoff = ON;
  ac.sys_param.lfo.detune = 0;


  copy_osc_sys_param_to_notes_osc(&ac.sys_param, ac.note);
  copy_osc_sys_param_to_lfo(&ac.sys_param, &ac.lfo);


  int testmidinotes[POLYPHONY_MAX]={60,64,67};

  for(int i=0;i<POLYPHONY_MAX;++i){
	  midi_note_ON(ac.note, testmidinotes[i], 127);
	  HAL_Delay(1000);
  }
  for(int j=0;j<POLYPHONY_MAX;++j){
  	  midi_note_OFF(ac.note, testmidinotes[j]);
  	  HAL_Delay(1000);
  }

  midi_note_ON(ac.note, 60, 127);

/*    //following code will test the arbitrary wave menu
    disp_Init_tab_arb();
    disp_Draw_arb_frame();
    disp_Draw_ARB_points();
    disp_ARB_Shift_Select_Right();
    double value = 0;
    for(int i=0; i<sizeOfTab*2;i++){
  	  value=0;
  	  for(int j=0; j<11;j++){
  		  value = 0.1+value;
  		  disp_Update_arb_selected(value);
  		  disp_Remove_arb_points();
  		  disp_Draw_ARB_points();
  	  }
  	  disp_Draw_ARB_points();
  	  disp_ARB_Shift_Select_Left();
    }*/

  // End of test code		////////////////////////////////




  /* USER CODE END 2 */

  /* Infinite loop */
  /* USER CODE BEGIN WHILE */
  while (1)
  {

    /* USER CODE END WHILE */

    /* USER CODE BEGIN 3 */
  }
  /* USER CODE END 3 */
}

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
