heolfief/minimood/Software/Firmware/Firmware.ioc

Mcu.UserName=STM32F446RETx
PA0-WKUP.GPIO_Label=CTRL_LEFT
PA0-WKUP.Signal=GPIO_Input
PA1.GPIO_Label=CTRL_UP
PA1.Signal=GPIO_Input
PA2.GPIO_Label=OSC1_AMP
PA2.Signal=ADCx_IN2
PA3.GPIO_Label=OSC2_AMP
PA3.Signal=ADCx_IN3
PA4.GPIO_Label=AUDIO_OUT
PA4.Signal=COMP_DAC1_group
PA5.GPIO_Label=LFO_CV_OUT
PA5.Signal=COMP_DAC2_group
PA6.GPIO_Label=LFO_RATE
PA6.Signal=ADCx_IN6
PA7.GPIO_Label=OSC3_DET
PA7.Signal=ADCx_IN7
PB0.GPIO_Label=OSC3_AMP
PB0.Signal=ADCx_IN8
PB1.GPIO_Label=OSC2_DET
PB1.Signal=ADCx_IN9
PB10.GPIO_Label=OSC3_ON
PB10.Signal=GPIO_Input
PB13.GPIO_Label=OSC3_WAVE
PB13.Signal=GPIO_Input
PB4.GPIO_Label=OSC1_ON
PB4.Signal=GPIO_Input
PB5.GPIO_Label=OSC2_WAVE
PB5.Signal=GPIO_Input
PB6.Signal=I2C1_SCL
PB7.Signal=I2C1_SDA
PB8.GPIO_Label=OSC1_WAVE
PB8.Signal=GPIO_Input
PB9.GPIO_Label=OSC2_ON
PB9.Signal=GPIO_Input
PC0.GPIO_Label=ADSR_D
PC0.Signal=ADCx_IN10
PC1.GPIO_Label=ADSR_A
PC1.Signal=ADCx_IN11
PC13.GPIO_Label=CTRL_DOWN
PC13.Signal=GPIO_Input
PC14-OSC32_IN.GPIO_Label=CTRL_RIGHT
PC14-OSC32_IN.Signal=GPIO_Input
PC15-OSC32_OUT.GPIO_Label=CTRL_OK
PC15-OSC32_OUT.Signal=GPIO_Input
PC2.GPIO_Label=ADSR_R
PC2.Signal=ADCx_IN12
PC3.GPIO_Label=ADSR_S
PC3.Signal=ADCx_IN13
PC4.GPIO_Label=OSC1_DET
PC4.Signal=ADCx_IN14
PC5.GPIO_Label=LFO_DEPTH
PC5.Signal=ADCx_IN15
PH0-OSC_IN.Signal=RCC_OSC_IN
PH1-OSC_OUT.Signal=RCC_OSC_OUT
