heolfief/minimood/Software/Firmware/Core/Inc/LUT.h

#define NUMBER_OF_WAVES 5

const float midi_to_phase_inc[128] = {
		0.750191,0.794800,0.842061,0.892132,0.945181,1.001385,1.060930,1.124016,1.190854,1.261666,1.336688,1.416172,1.500382,1.589599,1.684121,1.784265,
		1.890363,2.002769,2.121860,2.248033,2.381707,2.523331,2.673376,2.832344,3.000764,3.179198,3.368243,3.568529,3.780725,4.005539,4.243721,4.496065,
		4.763415,5.046662,5.346753,5.664687,6.001527,6.358396,6.736486,7.137059,7.561450,8.011078,8.487441,8.992130,9.526830,10.093325,10.693505,11.329374,
		12.003055,12.716792,13.472972,14.274117,15.122901,16.022156,16.974882,17.984261,19.053659,20.186649,21.387011,22.658749,24.006109,25.433584,26.945944,
		28.548235,30.245802,32.044312,33.949764,35.968521,38.107319,40.373299,42.774021,45.317497,48.012218,50.867168,53.891888,57.096470,60.491604,64.088623,
		67.899529,71.937042,76.214638,80.746597,85.548042,90.634995,96.024437,101.734337,107.783775,114.192940,120.983208,128.177246,135.799057,143.874084,152.429276,
		161.493195,171.096085,181.269989,192.048874,203.468674,215.567551,228.385880,241.966415,256.354492,271.598114,287.748169,304.858551,322.986389,342.192169,
		362.539978,384.097748,406.937347,431.135101,456.771759,483.932831,512.708984,543.196228,575.496338,609.717102,645.972778,684.384338,725.079956,768.195496,
		813.874695,862.270203,913.543518,967.865662,1025.417969,1086.392456,1150.992676
};

const int16_t wave_LUT[NUMBER_OF_WAVES][4096] = {
	// SINE WAVE
	{
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
	},

	// SQUARE WAVE
	{
		0xfa0,0xfa0,0xfa0,0xfa0,0xfa0,0xfa0,0xfa0,0xfa0,0xfa0,0xfa0,0xfa0,0xfa0,0xfa0,0xfa0,0xfa0,0xfa0,0xfa0,0xfa0,0xfa0,0xfa0,0xfa0,0xfa0,0xfa0,0xfa0,0xfa0,0xfa0,0xfa0,0xfa0,0xfa0,0xfa0,0xfa0,0xfa0,0xfa0,0xfa0,0xfa0,0xfa0,0xfa0,0xfa0,0xfa0,0xfa0,0xfa0,0xfa0,0xfa0,0xfa0,0xfa0,0xfa0,0xfa0,0xfa0,0xfa0,0xfa0,0xfa0,0xfa0,0xfa0,0xfa0,0xfa0,0xfa0,0xfa0,0xfa0,0xfa0,0xfa0,0xfa0,0xfa0,0xfa0,0xfa0,0xfa0,0xfa0,0xfa0,0xfa0,0xfa0,0xfa0,0xfa0,0xfa0,0xfa0,0xfa0,0xfa0,0xfa0,0xfa0,0xfa0,0xfa0,0xfa0,0xfa0,0xfa0,0xfa0,0xfa0,0xfa0,0xfa0,0xfa0,0xfa0,0xfa0,0xfa0,0xfa0,0xfa0,0xfa0,0xfa0,0xfa0,0xfa0,0xfa0,0xfa0,0xfa0,0xfa0,0xfa0,0xfa0,0xfa0,0xfa0,0xfa0,0xfa0,0xfa0,0xfa0,0xfa0,0xfa0,0xfa0,0xfa0,0xfa0,0xfa0,0xfa0,0xfa0,0xfa0,0xfa0,0xfa0,0xfa0,0xfa0,0xfa0,0xfa0,0xfa0,0xfa0,0xfa0,0xfa0,0xfa0,0xfa0,0xfa0,0xfa0,0xfa0,0xfa0,0xfa0,0xfa0,0xfa0,0xfa0,0xfa0,0xfa0,0xfa0,0xfa0,0xfa0,0xfa0,0xfa0,0xfa0,0xfa0,0xfa0,0xfa0,0xfa0,0xfa0,0xfa0,0xfa0,0xfa0,0xfa0,0xfa0,0xfa0,0xfa0,0xfa0,0xfa0,0xfa0,0xfa0,0xfa0,0xfa0,0xfa0,0xfa0,0xfa0,0xfa0,0xfa0,0xfa0,0xfa0,0xfa0,0xfa0,0xfa0,0xfa0,0xfa0,0xfa0,0xfa0,0xfa0,0xfa0,0xfa0,0xfa0,0xfa0,0xfa0,0xfa0,0xfa0,0xfa0,0xfa0,0xfa0,0xfa0,0xfa0,0xfa0,0xfa0,0xfa0,0xfa0,0xfa0,0xfa0,0xfa0,0xfa0,0xfa0,0xfa0,0xfa0,0xfa0,0xfa0,0xfa0,0xfa0,0xfa0,0xfa0,0xfa0,0xfa0,0xfa0,0xfa0,0xfa0,0xfa0,0xfa0,0xfa0,0xfa0,0xfa0,0xfa0,0xfa0,0xfa0,0xfa0,0xfa0,0xfa0,0xfa0,0xfa0,0xfa0,0xfa0,0xfa0,0xfa0,0xfa0,0xfa0,0xfa0,0xfa0,0xfa0,0xfa0,0xfa0,0xfa0,0xfa0,0xfa0,0xfa0,0xfa0,0xfa0,0xfa0,0xfa0,0xfa0,0xfa0,0xfa0,0xfa0,0xfa0,0xfa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
	},

	// ARB WAVE, defaut value is 0
	{
		0,
	}
};
