heolfief/minimood/(commit log)

2020-02-18 adapting the project settings
    no more compile errors, sorry
    [main.c]
2020-02-19 ADSR display frame
2020-02-19 Fix constant volume issue
    [main.c]
2020-02-20 Add simulation files for VCF
    [VCF.DSN, VCF.opj]
2020-02-20 Add VCF shematics (KiCad)
    [VCF.DSN, VCF.opj, main_board.kicad_pcb, main_board.sch]
2020-02-21 Add KiCad gitignore
2020-02-21 Remove unused files
    [main_board.sch]
2020-02-21 Add PCB module for VCF
    [main_board.kicad_pcb, main_board.sch]
2020-02-21 Add NUCLEO footprint
    [MCU.sch, analog.sch, main_board.kicad_pcb, main_board.sch]
2020-02-22 Add programming connector to PCB
    [MCU.sch, main_board.kicad_pcb]
2020-02-22 Add MIDI hardware
    [MCU.sch, MIDI.sch, analogFX.sch, main_board.kicad_pcb, main_board.sch]
2020-02-22 Add power supply schematics and layout
    [MCU.sch, MIDI.sch, analogFX.sch, main_board.kicad_pcb, main_board.sch, power.sch]
2020-02-22 Add missing power connection
    [MCU.sch]
2020-02-23 Add OLED screen to PCB
    [HMI.sch, MCU.sch, MIDI.sch, analogFX.sch, main_board.kicad_pcb, main_board.sch, power.sch]
2020-02-23 Add HMI buttons and pots to PCB
    [HMI.sch, MCU.sch, MIDI.sch, analogFX.sch, audio_out.sch, main_board.kicad_pcb, main_board.sch, power.sch]
2020-02-23 Place HMI
    [HMI.sch, MCU.sch, analogFX.sch, main_board.kicad_pcb, main_board.sch]
2020-02-23 Place connectors
    [analogFX.sch, main_board.kicad_pcb]
2020-02-25 Flip connectors, add 3D models
    [MCU.sch, MIDI.sch, USB 2.0 Type B Connector Right Angle (Würth 61400416121).stp, USB_Type_A_Socket.step, audio_out.sch, main_board.kicad_pcb, plastec_jack.stp]
2020-02-25 Add simulation file for Distortion
    [DISTORTION_ORCAD_SIMULATION.DSN, Distortion_Orcad_simulation.opj, VCF.DSN]
2020-02-25 Place VCF components, I2C bus
    [MCU.sch, main_board.kicad_pcb, main_board.sch]
2020-02-25 Add output buffer to VCF
    [VCF.DSN, VCF.opj]
2020-02-25 OSC frames added
2020-02-25 Update 3D view
    [MCU.sch, main_board.kicad_pcb, main_board.sch, power.sch]
2020-02-26 Route GPIO
    [HMI.sch, MCU.sch, analogFX.sch, audio_out.sch, main_board.kicad_pcb, main_board.sch, power.sch]
2020-02-26 Route PWR
    [MCU.sch, MIDI.sch, analogFX.sch, audio_out.sch, main_board.kicad_pcb, main_board.sch, power.sch]
2020-02-27 Cleanup routing
    [096_oled_display.STEP, main_board.kicad_pcb]
2020-02-29 Start ADC config
2020-03-01 Change GPIO config
    [HMI.sch, MCU.sch, MIDI.sch, analogFX.sch, audio_out.sch, main_board.kicad_pcb, main_board.sch, power.sch]
2020-03-01 Label GPIO, create HMI files
    [HMI.sch, main_board.sch]
2020-03-01 Add debounce capacitors
    [HMI.sch, main_board.kicad_pcb]
2020-03-02 Implement low-level software button debounce
2020-03-02 Implement process buttons : OSC ON
2020-03-02 Finish implementation of osc buttons
2020-03-06 correcting waveforms position / add selection of oscillos
    [main.c]
2020-03-08 Add capacitor to the output buffer Change capacitor value to the Tone/Volume stage Remove output resistor from the VCF Change resistor value of the output buffer
    [VCF.DSN, VCF.opj]
2020-03-08 Modify distortion components
    [DISTORTION_ORCAD_SIMULATION.DSN, Distortion_Orcad_simulation.opj]
2020-03-08 Add the output adaptation
    [OUTADAPTATION.DSN, OutAdaptation.opj]
2020-03-21 Add FX buffer and headphone amp to schematics
    [MCU.sch, analogFX.sch, audio_out.sch, main_board.sch]
2020-03-21 Route PCB changes
    [analogFX.sch, audio_out.sch, main_board.kicad_pcb]
2020-03-22 Replace diode by transistor and change the reference to 547B 557B
    [OUTADAPTATION.DSN, OutAdaptation.opj, VCF.opj]
2020-03-24 Fix GND via
    [main_board.kicad_pcb]
2020-03-26 Fix DRC issue
    [main_board.kicad_pcb]
2020-03-26 Add test points headers
    [MCU.sch, analogFX.sch, audio_out.sch, main_board.kicad_pcb, power.sch]
2020-03-29 Clean folder
    [DISTORTION_ORCAD_SIMULATION.DSN, Distortion_Orcad_simulation.opj, OUTADAPTATION.DSN, OutAdaptation.opj, VCF.DSN, VCF.opj]
2020-09-08 Use bare STM32 instead of nucleo board. Schematics update
    [MCU.sch, main_board.sch, power.sch]
2020-09-12 Re-layout HMI, pre route
    [MCU.sch, analogFX.sch, audio_out.sch, main_board.kicad_pcb, power.sch]
2020-09-13 Finish PCB routing
    [MCU.sch, main_board.kicad_pcb]
2020-09-23 Use headphone amp IC instead of discrete amp
    [MCU.sch, OUTADAPTATION.DSN, OutAdaptation.opj, RK09L12-L15H.STEP, analogFX.sch, audio_out.sch, main_board.kicad_pcb, main_board.sch]
2020-09-24 Fix HMI timer frequency to be exactly 50Hz
    [Firmware.ioc, main.c]
2020-09-24 Optimize interrupts, use proper callbacks
2020-09-24 Add I2C module to CubeMX to prepare Display_implement merge
2020-10-04 Fix sampling rate constant set to wrong value
    [osc.h]
2020-10-08 Cleanup unused timer
